GaragaKarthikeya/INSITU/experiments/results/kv_asymmetry_llama32.png

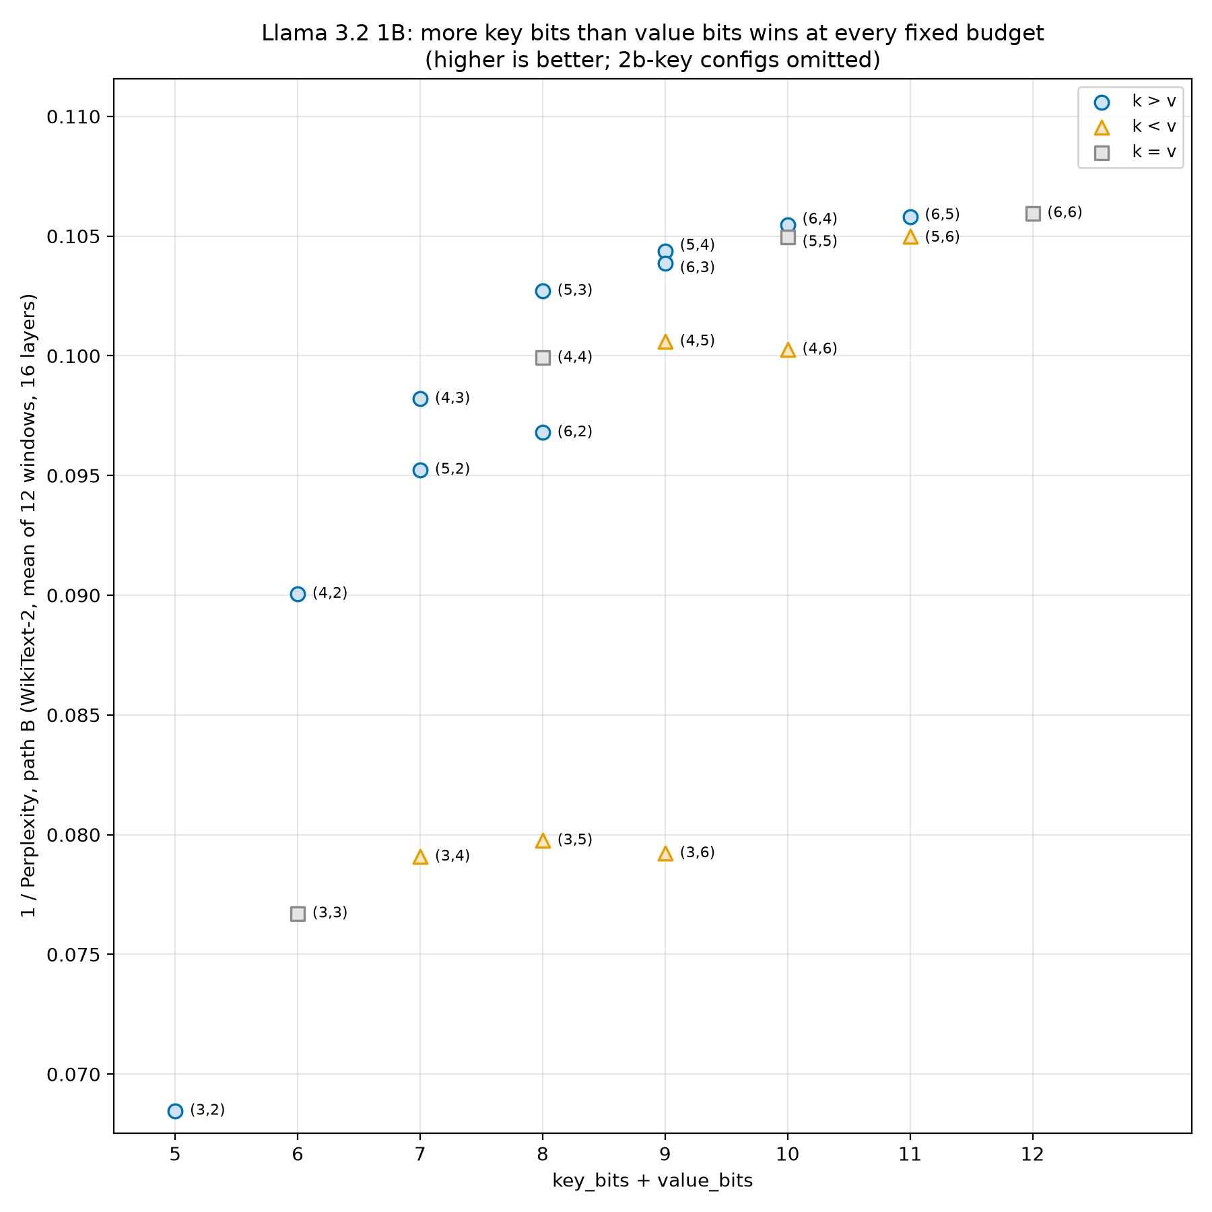
experiments/results/kv_asymmetry_llama32.png
