GaragaKarthikeya/INSITU/experiments/results/pareto_llama32_ppl_vs_bytes.png

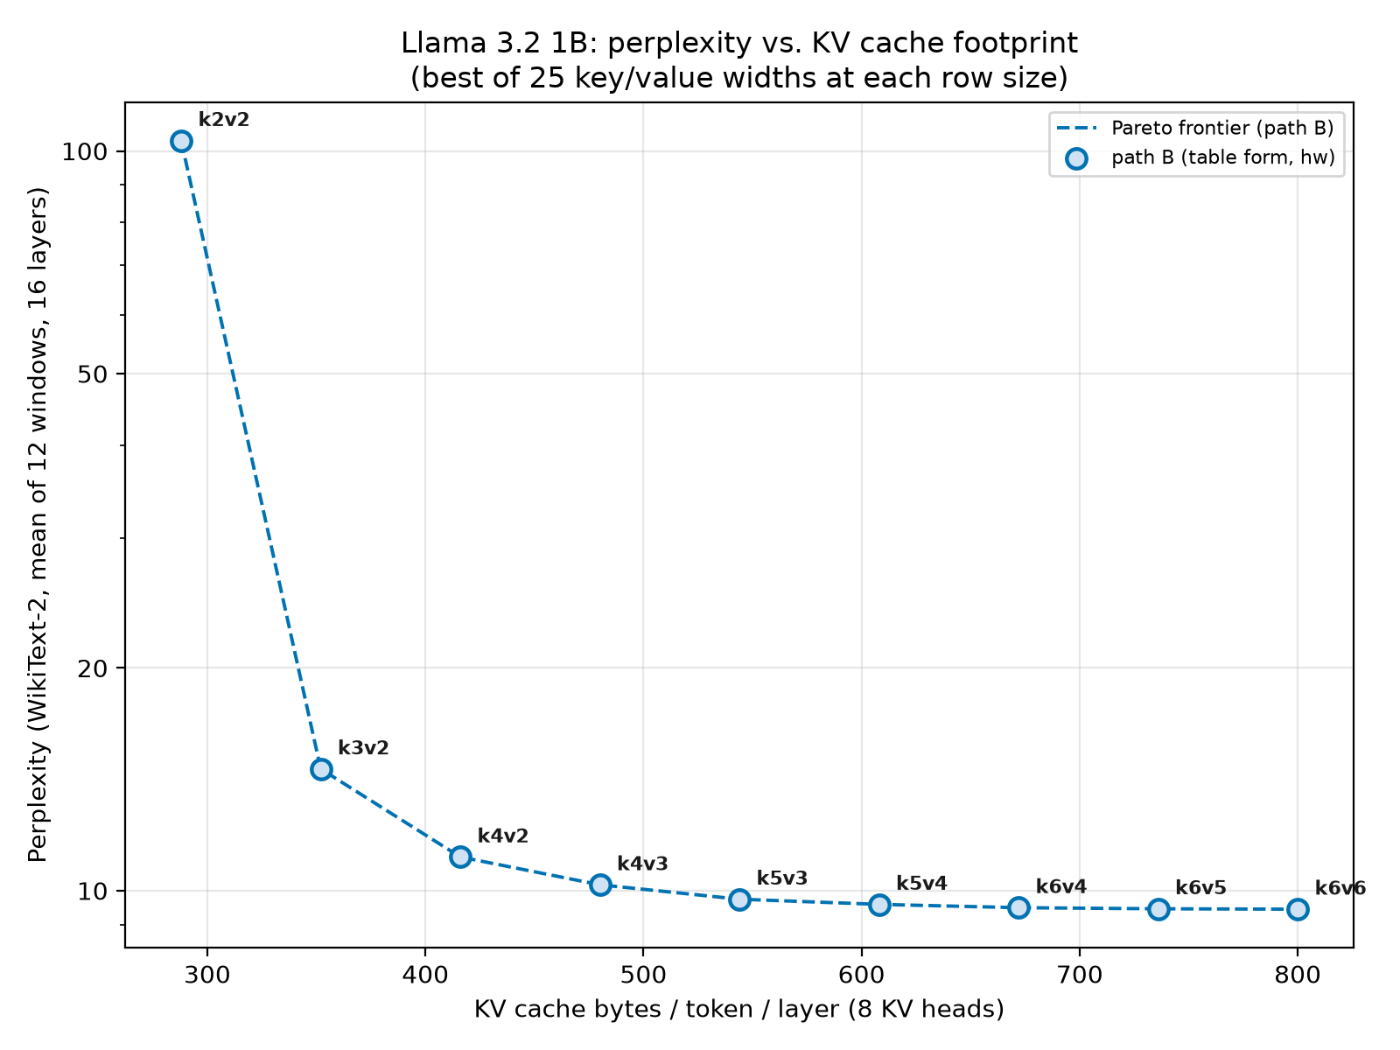
experiments/results/pareto_llama32_ppl_vs_bytes.png
