GaragaKarthikeya/INSITU/sw/attn_eth.c

/*
 * Raw Ethernet server on the A53. No IP, no lwIP, no OS. Step 14's transport.
 *
 * Why raw frames and not a socket stack
 * -------------------------------------
 * `plan.MD` budgets 35 us of round trip and 123 us of wire time for a 15 KB
 * token at ctx 32k, against 927 us of DDR -- so the network is a minor term
 * and the only thing that would make it a major one is a stack. lwIP on a
 * baremetal A53 costs more in copies and timers than the wire costs in
 * nanoseconds. A frame with a custom ethertype needs neither.
 *
 * The link is a metre of cable between two devices with nothing else on it, so
 * there is no retransmit and no congestion control. A dropped frame is a bug
 * to find, not a condition to recover from -- and the host's sequence number
 * is what turns "we lost one" into an error rather than into a wrong answer.
 *
 * Fragmentation, because 9,216 bytes does not fit in a frame
 * ----------------------------------------------------------
 * A request is the header plus up to 9,216 bytes of token, and an untagged
 * frame carries 1,500. So a request arrives as a run of frames each carrying
 * `{seq, frag, nfrag}` and its slice of the byte stream, and the server
 * reassembles by offset rather than by arrival order. `host/attn_client.py`'s
 * `RawEthClient` is the other half and the two share `attn_proto.h`.
 *
 * The payload is never touched
 * ----------------------------
 * Fragments are reassembled straight into the DMA's transmit buffer, so the
 * bytes that came off the wire are the bytes the core consumes. That is the
 * rule `attn_proto.h` is built around: any repacking here is a memcpy of the
 * whole token on the critical path, and step 13 measured that at 366 us
 * against 67 us of block.
 */
#include <string.h>

#include "xemacps.h"
#include "xil_cache.h"
#include "xil_printf.h"
#include "xparameters.h"
#if __has_include("xtime_l.h")
#include "xtime_l.h"
#else
#include "xiltimer.h"
#include "xtimer_config.h"
#endif

#include "attn_eth.h"
#include "attn_proto.h"

/* GEM3 is the ZCU104's RJ45. Enabled in `create_bd_attn_dma.tcl`; the device
 * tree carried `status = "disabled"` before that and nothing here would have
 * worked. */
#define GEM_BASE        0xFF0E0000U

#define RXBD_COUNT      64
#define TXBD_COUNT      64
/* JUMBO. A reply is 6,188 bytes and a request 9,252; at a 1,500-byte MTU those
 * are five and seven frames. Five-frame replies are what kills this receiver --
 * 256 consecutive single-frame replies never did -- so the cheapest cure is to
 * stop sending five. At an MTU of 9,000 a reply is one frame and a request is
 * two. The GEM supports 10,240 (XEMACPS_RX_BUF_SIZE_JUMBO); the host side sets
 * its interface to match. */
#define FRAME_MAX       9728
#define BD_ALIGN        64

/* One DESCRIPTOR per cache LINE, and that IS the whole point.
 *
 * A descriptor is 16 bytes and a cache line is 64, so at the driver's natural
 * packing four descriptors share a line. Cache maintenance has no finer
 * granularity than a line, so flushing the one descriptor this side just
 * modified also writes back stale copies of its three neighbours -- erasing
 * whatever the GEM had written into them in the meantime.
 *
 * That is the bug behind every receive failure in this file. The whole-ring
 * flush destroyed all 64; the per-descriptor flush that replaced it still
 * destroyed 3 at a time, which is why reception survived sixteen single-frame
 * loads and died on the first request whose reply took five frames.
 *
 * `XEmacPs_BdRingCreate` spaces descriptors by whatever alignment it is given,
 * so asking for 64 puts each on its own line and makes a single-descriptor
 * flush mean exactly one descriptor. It costs 4 KB of BSS. */
#define BD_SEP          64

/* Our MAC. Locally administered (bit 1 of the first octet), so it cannot
 * collide with a real vendor's, and fixed so the host can address us without
 * discovery. */
static const u8 BOARD_MAC[6] = {0x02, 0x00, 0x5A, 0x77, 0xE0, 0x01};

static XEmacPs emac;

/* BD rings and buffers, uncached-by-flushing. The GEM masters DDR directly and
 * is not coherent with these caches, so every descriptor and buffer is flushed
 * before the hardware reads it and invalidated after the hardware writes it.
 * This is the same discipline the KV image needs, and the same bug if missed:
 * correct hardware, stale memory.
 *
 * `XEmacPs_BdRingMemCalc` sizes these rather than hand arithmetic. (An earlier
 * comment here claimed the hand-rolled size was four times too small and that
 * this was why the receiver was dead. It was not: the board reports
 * `rings 1024+256 B for 64+16 descriptors`, and the hand-rolled array was
 * 2,048 bytes -- larger than needed. The real fault was cache, below. The
 * driver's own macro is kept because it cannot be wrong, not because the old
 * one was.) */
/* `XEmacPs_BdRingMemCalc` sizes for the descriptors alone and not for the
 * separation the alignment forces: at BD_SEP = 64 it answered 1,024 bytes for
 * 64 descriptors that occupy 4,096. The ring then runs off the end of the
 * array. The bring-up line printing "1024 B for 64 descriptors at 64 B each"
 * is what caught it -- three numbers that cannot all be true. */
#define RXBD_BYTES  (RXBD_COUNT * BD_SEP)
#define TXBD_BYTES  (TXBD_COUNT * BD_SEP)

static u8 rx_bd_space[RXBD_BYTES] __attribute__((aligned(BD_ALIGN)));
static u8 tx_bd_space[TXBD_BYTES] __attribute__((aligned(BD_ALIGN)));

/* Parking descriptors for the priority queues this design does not use. */
static XEmacPs_Bd bd_rx_park __attribute__((aligned(BD_ALIGN)));
static XEmacPs_Bd bd_tx_park __attribute__((aligned(BD_ALIGN)));
static u8 rx_buf[RXBD_COUNT][FRAME_MAX] __attribute__((aligned(BD_ALIGN)));
static u8 tx_buf[FRAME_MAX] __attribute__((aligned(BD_ALIGN)));

static u8 host_mac[6];
static int host_known;

/* The DRIVER does NO cache MAINTENANCE ON DESCRIPTORS. `xemacps_bdring.c`
 * contains no `Xil_DCache*` call of any kind -- every flush and invalidate is
 * the caller's job. The A53 writes descriptors into cached DDR, the GEM reads
 * DDR without coherency, and so it sees whatever was in memory before the
 * cache lines were written back: zeros. It then owns no receive buffers and
 * accepts no frames, which is precisely the `rx 0 (0 ours)` this reported with
 * the PHY up and the link negotiated at 1 Gb/s.
 *
 * FLUSHING the whole RING IS wrong once the GEM IS RUNNING, and IT cost A
 * Whole DEBUG cycle. The GEM writes status bits into descriptors as frames
 * land. A flush of the entire ring writes this side's stale cached copies back
 * over those updates, erasing them -- the frames are received and then
 * un-received. The symptom was precise and misleading: the first request
 * assembled perfectly (7/7 fragments, every header field correct, the step ran
 * and replied in 22 us) and then reception stopped dead, because the flush
 * after the first frame clobbered the descriptors the GEM had already filled
 * for the rest.
 *
 * So a flush covers exactly the one descriptor this side modified. Whole-ring
 * INVALIDATE stays: it discards clean lines and can only lose data this side
 * has written and not flushed, which by construction never happens.
 * Whole-ring flush is kept only for setup, before the GEM is started. */
/* Exactly one descriptor, which is exactly one cache line -- see BD_SEP. */
static void bd_flush_one(void *bd) { Xil_DCacheFlushRange((UINTPTR)bd, BD_SEP); }
static void bd_inval_rx(void)  { Xil_DCacheInvalidateRange((UINTPTR)rx_bd_space, RXBD_BYTES); }
static void bd_inval_tx(void)  { Xil_DCacheInvalidateRange((UINTPTR)tx_bd_space, TXBD_BYTES); }
static void bd_flush_all(void) {
    Xil_DCacheFlushRange((UINTPTR)rx_bd_space, RXBD_BYTES);
    Xil_DCacheFlushRange((UINTPTR)tx_bd_space, TXBD_BYTES);
}

/* Counted and printed, because a silent receiver and a receiver that drops
 * everything look identical from the far end. `rx_any` is every frame the MAC
 * accepted; `rx_ours` is those with our ethertype. If the first is climbing
 * and the second is not, the filter or the ethertype is wrong -- which is a
 * different bug from a dead link, and the UART should say which. */
static u32 rx_any, rx_ours, tx_frames, rx_stalls, tx_errs;

/* --------------------------------------------------------------------------
 * PHY
 *
 * The address is SCANNED, not assumed. Boards move the DP83867 between MDIO
 * addresses and a wrong constant looks exactly like a dead link -- which is
 * the least diagnosable failure in this whole file.
 * -------------------------------------------------------------------------- */
static int phy_find(XEmacPs *e)
{
    for (u32 a = 0; a < 32; a++) {
        u16 id1 = 0, id2 = 0;
        XEmacPs_PhyRead(e, a, 2, &id1);
        XEmacPs_PhyRead(e, a, 3, &id2);
        if (id1 != 0xFFFF && id1 != 0x0000) {
            xil_printf("ETH: PHY at MDIO %u (id %04x:%04x)\r\n",
                       (unsigned)a, id1, id2);
            return (int)a;
        }
    }
    return -1;
}

static int phy_wait_link(XEmacPs *e, u32 phy, u32 timeout_ms)
{
    /* Status register bit 2 is link, and it is LATCHING low: it must be read
     * twice to clear a stale down-event, or a link that came up before this
     * ran reports itself as down forever. */
    for (u32 i = 0; i < timeout_ms; i++) {
        u16 st = 0;
        XEmacPs_PhyRead(e, phy, 1, &st);
        XEmacPs_PhyRead(e, phy, 1, &st);
        if (st & 0x0004U)
            return 1;
        for (volatile int d = 0; d < 100000; d++) { }
    }
    return 0;
}

/* Link speed from the DP83867's status register 0x11, which is where it
 * reports the NEGOTIATED rate. Reading the control register instead gives what
 * was ADVERTISED, which is not the same thing on a link that fell back. */
static u32 phy_speed(XEmacPs *e, u32 phy)
{
    u16 s = 0;
    XEmacPs_PhyRead(e, phy, 0x11, &s);
    switch ((s >> 14) & 0x3U) {
    case 0: return 10;
    case 1: return 100;
    case 2: return 1000;
    default: return 0;
    }
}

/* --------------------------------------------------------------------------
 * bring-up
 * -------------------------------------------------------------------------- */
int attn_eth_init(void)
{
    XEmacPs_Config *cfg = XEmacPs_LookupConfig(GEM_BASE);
    if (!cfg) {
        xil_printf("ETH: no GEM config at %08x -- is ENET3 enabled in the BD?\r\n",
                   (unsigned)GEM_BASE);
        return -1;
    }
    if (XEmacPs_CfgInitialize(&emac, cfg, cfg->BaseAddress) != XST_SUCCESS) {
        xil_printf("ETH: CfgInitialize failed\r\n");
        return -1;
    }
    /* Before anything else: the option changes the DMA receive buffer size the
     * driver programs, so it has to be set before the rings are built. */
    if (XEmacPs_SetOptions(&emac, XEMACPS_JUMBO_ENABLE_OPTION) != XST_SUCCESS) {
        xil_printf("ETH: the controller refused jumbo frames\r\n");
        return -1;
    }
    XEmacPs_SetMacAddress(&emac, (void *)BOARD_MAC, 1);

    int phy = phy_find(&emac);
    if (phy < 0) {
        xil_printf("ETH: no PHY answered on MDIO 0..31\r\n");
        return -1;
    }
    if (!phy_wait_link(&emac, (u32)phy, 5000)) {
        xil_printf("ETH: no link. Is the cable in?\r\n");
        return -1;
    }
    u32 mbps = phy_speed(&emac, (u32)phy);
    xil_printf("ETH: link up at %u Mb/s\r\n", (unsigned)mbps);
    if (mbps == 0)
        return -1;
    XEmacPs_SetOperatingSpeed(&emac, (u16)mbps);
    /* `XEmacPs_SetOperatingSpeed` writes the MAC's NWCFG register only -- it
     * does not touch the CRL_APB TX clock divisor. That is `psu_init`'s job,
     * which does it now that ENET3 is enabled in the block design. */
    XEmacPs_SetMdioDivisor(&emac, MDC_DIV_224);

    /* -- BD rings ------------------------------------------------------- */
    XEmacPs_BdRing *rxr = &XEmacPs_GetRxRing(&emac);
    XEmacPs_BdRing *txr = &XEmacPs_GetTxRing(&emac);
    XEmacPs_Bd tmpl;

    XEmacPs_BdClear(&tmpl);
    if (XEmacPs_BdRingCreate(rxr, (UINTPTR)rx_bd_space, (UINTPTR)rx_bd_space,
                             BD_SEP, RXBD_COUNT) != XST_SUCCESS ||
        XEmacPs_BdRingClone(rxr, &tmpl, XEMACPS_RECV) != XST_SUCCESS) {
        xil_printf("ETH: rx ring setup failed\r\n");
        return -1;
    }
    XEmacPs_BdClear(&tmpl);
    XEmacPs_BdSetStatus(&tmpl, XEMACPS_TXBUF_USED_MASK);
    if (XEmacPs_BdRingCreate(txr, (UINTPTR)tx_bd_space, (UINTPTR)tx_bd_space,
                             BD_SEP, TXBD_COUNT) != XST_SUCCESS ||
        XEmacPs_BdRingClone(txr, &tmpl, XEMACPS_SEND) != XST_SUCCESS) {
        xil_printf("ETH: tx ring setup failed\r\n");
        return -1;
    }

    bd_flush_all();

    /* Hand every receive buffer to the hardware. */
    for (int i = 0; i < RXBD_COUNT; i++) {
        XEmacPs_Bd *bd;
        if (XEmacPs_BdRingAlloc(rxr, 1, &bd) != XST_SUCCESS) return -1;
        XEmacPs_BdSetAddressRx(bd, (UINTPTR)rx_buf[i]);
        XEmacPs_BdClearRxNew(bd);
        Xil_DCacheInvalidateRange((UINTPTR)rx_buf[i], FRAME_MAX);
        if (XEmacPs_BdRingToHw(rxr, 1, bd) != XST_SUCCESS) return -1;
    }
    /* The descriptors the GEM is about to fetch. Without this it fetches the
     * pre-`ToHw` contents and owns nothing. Safe as a whole-ring flush because
     * the GEM has not been started yet and owns none of them. */
    bd_flush_all();

    /* TIE OFF the QUEUES this DESIGN does not USE.
     *
     * The ZynqMP GEM supports priority queuing, and the driver's own examples
     * park every queue but the one in use -- "for avoiding the controller to
     * malfunction by fetching the descriptors from these queues". Leaving them
     * unset is not a performance question: the controller reads whatever the
     * pointers happen to contain and the receiver stops working. That is what
     * `rx 0 (0 ours)` on the UART looked like, with the PHY up and the link
     * negotiated at 1 Gb/s. */
    if (emac.MaxQueues > 1) {
        XEmacPs_BdClear(&bd_rx_park);
        XEmacPs_BdSetAddressRx(&bd_rx_park,
                               (XEMACPS_RXBUF_NEW_MASK | XEMACPS_RXBUF_WRAP_MASK));
        XEmacPs_BdClear(&bd_tx_park);
        XEmacPs_BdSetStatus(&bd_tx_park,
                            (XEMACPS_TXBUF_USED_MASK | XEMACPS_TXBUF_WRAP_MASK));
        Xil_DCacheFlushRange((UINTPTR)&bd_rx_park, 64);
        Xil_DCacheFlushRange((UINTPTR)&bd_tx_park, 64);
        for (u8 q = 0; q < emac.MaxQueues; q++) {
            if (q == 0) continue;
            XEmacPs_SetQueuePtr(&emac, (UINTPTR)&bd_rx_park, q, XEMACPS_RECV);
            XEmacPs_SetQueuePtr(&emac, (UINTPTR)&bd_tx_park, q, XEMACPS_SEND);
        }
        xil_printf("ETH: parked %u unused queues\r\n",
                   (unsigned)(emac.MaxQueues - 1));
    }

    XEmacPs_SetQueuePtr(&emac, emac.RxBdRing.BaseBdAddr, 0, XEMACPS_RECV);
    XEmacPs_SetQueuePtr(&emac, emac.TxBdRing.BaseBdAddr, 0, XEMACPS_SEND);

    /* The screening register the example sets alongside the queue pointers:
     * it is what routes matching frames to queue 0. */
    XEmacPs_WriteReg(emac.Config.BaseAddress, XEMACPS_SCREEN_TYPE2_REG0,
                     XEMACPS_CMPA_ENABLE_MASK | 0U);

    XEmacPs_Start(&emac);

    xil_printf("ETH: rings %u+%u B for %u+%u descriptors at %u B each "
               "(bd %u B), %u queues\r\n",
               (unsigned)RXBD_BYTES, (unsigned)TXBD_BYTES,
               (unsigned)RXBD_COUNT, (unsigned)TXBD_COUNT, (unsigned)BD_SEP,
               (unsigned)sizeof(XEmacPs_Bd), (unsigned)emac.MaxQueues);
    xil_printf("ETH: jumbo on, frame buffer %u B, reply fits in one frame\r\n",
               (unsigned)FRAME_MAX);
    xil_printf("ETH: ready, MAC %02x:%02x:%02x:%02x:%02x:%02x, ethertype %04x\r\n",
               BOARD_MAC[0], BOARD_MAC[1], BOARD_MAC[2],
               BOARD_MAC[3], BOARD_MAC[4], BOARD_MAC[5],
               (unsigned)ATTN_ETHERTYPE);
    return 0;
}

/* --------------------------------------------------------------------------
 * one frame in, one frame out
 * -------------------------------------------------------------------------- */
int attn_eth_recv(u8 *dst, int max)
{
    XEmacPs_BdRing *rxr = &XEmacPs_GetRxRing(&emac);
    XEmacPs_Bd *bd;

    /* CLEAR the receive STATUS, OR the GEM STOPS for good.
     *
     * `XEMACPS_RXSR_BUFFNA_MASK` latches the instant the controller finds no
     * free descriptor -- even for one frame, even momentarily -- and while it
     * is set the receiver stays off no matter how many descriptors are handed
     * back afterwards. It is write-one-to-clear, and the only code in the
     * driver that clears it lives in `xemacps_intr.c`. This server is polled
     * and installs no handler, so nothing cleared it.
     *
     * That is why reception ran perfectly for 1,600 frames -- 256 cache-zeroing
     * loads and nine decode steps, counters advancing +7 and +5 exactly on
     * schedule -- and then stopped dead. Overrun and a bad AHB response latch
     * the same way and are cleared here too. */
    {
        u32 sr = XEmacPs_ReadReg(emac.Config.BaseAddress, XEMACPS_RXSR_OFFSET);
        if ((sr & XEMACPS_RXSR_ERROR_MASK) != 0U) {
            XEmacPs_WriteReg(emac.Config.BaseAddress, XEMACPS_RXSR_OFFSET, sr);
            if (++rx_stalls <= 4U)
                xil_printf("ETH: rx status %08x cleared (#%u) after %u frames\r\n",
                           (unsigned)sr, (unsigned)rx_stalls, (unsigned)rx_any);
        }
    }

    /* The GEM marks a descriptor used by writing DDR; this side must not read
     * that through a stale cache line. */
    bd_inval_rx();
    if (XEmacPs_BdRingFromHwRx(rxr, 1, &bd) == 0)
        return 0;

    u32 len = XEmacPs_BdGetLength(bd);
    UINTPTR addr = XEmacPs_BdGetBufAddr(bd);
    Xil_DCacheInvalidateRange(addr, len);

    int taken = 0;
    const u8 *f = (const u8 *)addr;
    rx_any++;
    if (rx_any <= 4)
        xil_printf("ETH: rx #%u len %u type %04x from "
                   "%02x:%02x:%02x:%02x:%02x:%02x\r\n",
                   (unsigned)rx_any, (unsigned)len,
                   (unsigned)((f[12] << 8) | f[13]),
                   f[6], f[7], f[8], f[9], f[10], f[11]);
    /* 12 bytes of MAC, 2 of ethertype. Anything else on the wire -- and on a
     * direct cable there should be nothing -- is dropped here. */
    if (len > 14 && ((f[12] << 8) | f[13]) == ATTN_ETHERTYPE) {
        rx_ours++;
        if (!host_known) {
            memcpy(host_mac, f + 6, 6);      /* reply to whoever asked */
            host_known = 1;
            xil_printf("ETH: host is %02x:%02x:%02x:%02x:%02x:%02x\r\n",
                       f[6], f[7], f[8], f[9], f[10], f[11]);
        }
        taken = (int)len - 14;
        if (taken > max) taken = max;
        memcpy(dst, f + 14, (size_t)taken);
    }

    /* Give the buffer straight back, whether it was ours or not: a ring that
     * leaks descriptors stops receiving after RXBD_COUNT frames, which looks
     * like the host going quiet. */
    XEmacPs_BdRingFree(rxr, 1, bd);
    if (XEmacPs_BdRingAlloc(rxr, 1, &bd) == XST_SUCCESS) {
        XEmacPs_BdSetAddressRx(bd, addr);
        /* CLEARING "new" IS the CALLER'S JOB, and FORGETTING IT IS AN INFINITE
         * LOOP RATHER THAN A DROPPED FRAME.
         *
         * Bit 0 of an RX descriptor's address word means "the GEM has filled
         * this buffer". The CPU clears it to hand ownership back.
         * `XEmacPs_BdSetAddressRx` deliberately PRESERVES the low bits (it
         * masks the address in), and `XEmacPs_BdRingToHw` never touches them
         * -- `RXBUF_NEW_MASK` does not appear in any of the driver's .c files.
         *
         * Left set, the GEM will not reuse the buffer, `BdRingFromHwRx`
         * reports it complete again on the very next call, and the same frame
         * is delivered forever. The board served the same request 948,353
         * times and saturated the link at 300 Mb/s; from the host it looked
         * like a hang eight layers in. */
        XEmacPs_BdClearRxNew(bd);
        Xil_DCacheInvalidateRange(addr, FRAME_MAX);
        XEmacPs_BdRingToHw(rxr, 1, bd);
        bd_flush_one(bd);          /* THIS descriptor only -- see above */
    } else {
        /* Silently losing a descriptor drains the ring one frame at a time and
         * ends in a receiver that has simply stopped. */
        xil_printf("ETH: rx ring exhausted -- a descriptor leaked\r\n");
    }
    return taken;
}

int attn_eth_send(const u8 *payload, int len)
{
    if (!host_known || len > FRAME_MAX - 14)
        return -1;

    XEmacPs_BdRing *txr = &XEmacPs_GetTxRing(&emac);
    XEmacPs_Bd *bd;

    memcpy(tx_buf, host_mac, 6);
    memcpy(tx_buf + 6, BOARD_MAC, 6);
    tx_buf[12] = (u8)(ATTN_ETHERTYPE >> 8);
    tx_buf[13] = (u8)(ATTN_ETHERTYPE & 0xFF);
    memcpy(tx_buf + 14, payload, (size_t)len);

    int total = len + 14;
    /* The minimum Ethernet frame is 60 bytes before the FCS. Short frames are
     * padded by the MAC on this part, but the padding is not zeroed -- so it
     * is zeroed here rather than sending whatever was in the buffer. */
    if (total < 60) {
        memset(tx_buf + total, 0, (size_t)(60 - total));
        total = 60;
    }
    Xil_DCacheFlushRange((UINTPTR)tx_buf, (u32)total);

    if (XEmacPs_BdRingAlloc(txr, 1, &bd) != XST_SUCCESS)
        return -1;
    XEmacPs_BdSetAddressTx(bd, (UINTPTR)tx_buf);
    XEmacPs_BdSetLength(bd, (u32)total);
    XEmacPs_BdClearTxUsed(bd);
    XEmacPs_BdSetLast(bd);
    if (XEmacPs_BdRingToHw(txr, 1, bd) != XST_SUCCESS) {
        /* Returning without freeing leaks a descriptor, and sixteen leaks is a
         * transmitter that has silently stopped. Every exit below frees. */
        XEmacPs_BdRingUnAlloc(txr, 1, bd);
        xil_printf("ETH: ToHw refused a tx descriptor\r\n");
        return -1;
    }
    bd_flush_one(bd);
    XEmacPs_Transmit(&emac);

    /* Polled: wait for the descriptor to come back before reusing `tx_buf`. */
    /* Polled completion. The guard is small enough that a stuck transmitter is
     * reported in milliseconds rather than looking like a hang, and the
     * descriptor is freed either way. */
    u32 guard = 2000000;
    while (guard) {
        bd_inval_tx();
        if (XEmacPs_BdRingFromHwTx(txr, 1, &bd) != 0) break;
        guard--;
    }
    if (!guard) {
        xil_printf("ETH: tx did not complete (%u frames sent so far)\r\n",
                   (unsigned)tx_frames);
        return -1;
    }
    XEmacPs_BdRingFree(txr, 1, bd);
    tx_frames++;
    /* The transmit side latches the same way: a used-bit-read or an underrun
     * stops it until acknowledged. */
    {
        u32 sr = XEmacPs_ReadReg(emac.Config.BaseAddress, XEMACPS_TXSR_OFFSET);
        if ((sr & XEMACPS_TXSR_ERROR_MASK) != 0U) {
            XEmacPs_WriteReg(emac.Config.BaseAddress, XEMACPS_TXSR_OFFSET, sr);
            if (++tx_errs <= 4U)
                xil_printf("ETH: tx status %08x cleared (#%u)\r\n",
                           (unsigned)sr, (unsigned)tx_errs);
        }
    }
    return len;
}

void attn_eth_forget_host(void)
{
    host_known = 0;
}

void attn_eth_stats(u32 *any, u32 *ours, u32 *tx)
{
    if (any)  *any  = rx_any;
    if (ours) *ours = rx_ours;
    if (tx)   *tx   = tx_frames;
}

u32 attn_eth_stalls(void) { return rx_stalls; }
