GaragaKarthikeya/INSITU/(commit log)

2026-09-03 Add unit tests for numerics, quantization, rotation, and tracing
    - Introduced `test_numerics.py` to validate fixed-point and floating-point operations, including Hadamard transforms, rounding modes, and quantization behavior.
    - Created `test_quantize.py` to ensure lossless encoding/decoding, validate distortion bounds, and check quantizer behavior with various configurations.
    - Added `test_rotation.py` to verify orthonormality, inner product preservation, and the effects of different seeds on rotation transformations.
    - Implemented `trace.py` to log operations performed during computations, capturing details about memory usage and operation counts.
    - Introduced `weights.py` to manage weights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
2026-09-03 Model Llama 3's RoPE frequency scaling
    `ModelConfig.from_hf` refused any rope_type but "default", so Llama-3.2-1B
    could not be grafted at all: it sets rope_type "llama3", a wavelength-piecewise
    rescaling of inv_freq. Refusing was right -- serving a scaled model on the
    default table misplaces tokens and produces fluent nonsense -- but it left the
    kernel unable to run on the model.
    `RopeScaling` implements the three regimes: short wavelengths untouched, long
    divided by `factor`, the band between them linearly interpolated. It is applied
    once when the sin/cos table is built, so it changes the table and nothing else
    -- the apply path, the trace it emits and the cycles hw/ replays are identical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
    [run.py, test_rope_scaling.py]
2026-09-04 Plan the host/PL split and model the PL side in Python
    Steps 1-4 of plan.MD, the Python half. The seam is placed after RoPE and
    before W_o', on a value kernel.py already computes, so no numeric path
    changes: 124 checks and the cosine 1.000000 control stay green.
    - config.py: RotateConfig, EncoderConfig, AttentionConfig, CacheConfig and
    HardwareConfig.zcu104(), pinning 250 MHz and a 4x128 b interface.
    - hw/attn_block.py: RotateUnit, EncoderUnit, AttentionUnit, CacheBandwidth.
    replay resolves every unit by getattr; a unit that costs the PL nothing
    must be declared in HOST_UNITS with its reason. SCORE and ACCUMULATE are
    the max, not the sum, and the cache reports both of its bounds.
    -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
    [run.py, test_hardware.py]
2026-09-04 Measure ZCU104 DDR bandwidth before sizing anything against it
    Step 1. The whole design was sized from an assumed ~13.4 GB/s, so measure
    it first: 4 AXI-HP masters over a multi-MB region, swept at runtime from one
    bitstream across ports x burst x outstanding. Closed at 250 MHz, two runs
    across a power cycle, run 2 taking the median of five repeats.
    14,708 MB/s at 4 ports, burst 64, outstanding 2 -- 77% of the DDR4-2400
    peak, against the engine's 13.0 GB/s appetite. The gate passes with 13%
    headroom; PARALLEL_KV=1 needs no clock or format change.
    The prefetcher must be shallow. Depth 2 beats depth 4+ by 19%, and the
    deeper queues are also 3-6% noisy against 0.25% at depth 2 -- four streams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
2026-09-04 Implement the forward randomized FWHT rotation in RTL
    Step 5. rot_fwht.sv: six levels of 32 add/sub butterflies, the seed-0 sign
    diagonal as a SIGN_NEG parameter, exact >>> 3. The non-exact branch is a
    compile-time absence -- SHIFT is hard-coded for d = 64, and any other
    dimension belongs on ops/rotate.py's reciprocal-multiply path.
    Sign extension happens before the diagonal negation, because -24'sh800000
    is +2^23 and does not fit the input width. range_error reports a normalized
    result too wide for 24 bits rather than wrapping behind the numeric model.
    tb_rot checks 1,072 vectors -- the 48 real q/k/v tensors tapped from the
    unmodified kernel plus 1,024 random -- and asserts the DUT sign w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
    [rot_fwht.sv, tb_rot.sv]
2026-09-04 Encode a rotated vector to codes and a norm, in RTL
    Step 6. rot_norm.sv is the only producer of the norm: RMS at wire precision,
    rounded half-to-even, so the encoder thresholds against the same integer the
    cache row carries. Thresholding against a wider norm would put encoder and
    decoder on different numbers and decode near-boundary channels into the wrong
    bin -- a fraction of a percent, invisible to every test not looking for it.
    rot_encode.sv scales the boundaries by that norm once per vector, so there is
    no divider and every channel is a comparison.
    Both blocks fold 8 of 64 channels per cycle. Phase A runs once per token
    against a Phase B that runs once per CACHED token, so 64 squarers a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
    [rot_encode.sv, rot_norm.sv, tb_rot_encode.sv, tb_rot_norm.sv, test_hardware.py]
2026-09-04 Score a cached row against a precomputed product table, in RTL
    Step 7. `qtab_build.sv` builds the 64 x 16 table of q_rot[ch] * centroid[i]
    once per query vector; `score_lane.sv` gathers it at a row's key codes, reduces
    in six levels, multiplies by the row's norm and shifts. Two DSPs in the inner
    loop where a dense unit needs sixty-four.
    2,080 scores bit-exact against CompressedAttention.scores -- all 32 query heads
    against the 65 cached tokens those scores were computed over -- plus 32,768
    table entries swept exhaustively and 239 stalled cycles of back-pressure. The
    lane splits the raw 52-byte row itself, so _pack_codes's layout is under test
    rather than mirrored.
    Two corrections that meas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
    [qtab_build.sv, score_lane.sv, tb_qtab_build.sv, tb_score_lane.sv, test_vectors.py]
2026-09-04 Run the online softmax and the value accumulator in RTL
    Step 8. `exp_lut.sv` is exp(-x) as a 256-entry fraction table and a shift;
    `softmax_online.sv` carries the running maximum and sum, speculating "no new
    max" and stalling to rescale on the rare path; `accum.sv` folds the value plane
    into 64 channels through four multipliers and a mux.
    Bit-exact against `attend_online` -- not `attend_two_pass` -- on every token:
    m, l, the probability, the rescale factor and all 64 accumulator channels, over
    two stimulus sets x 4 lanes x 65 tokens, plus 13,565 exp deltas.
    `CompressedAttention.on_step` is a new read-only observer, same `is not None`
    contract as `AttentionKernel.on_stage`, so the goldens co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
    [accum.sv, exp_lut.sv, softmax_online.sv, tb_exp_lut.sv, tb_softmax_accum.sv, test_vectors.py]
2026-09-04 Divide by the softmax denominator, in RTL
    Step 9, which closes Phase 2. `finalize.sv` inverts `l` once per query head --
    32 cycles of restoring division -- and multiplies the 64 accumulator channels
    by it, four per cycle. Its output is the seam: `merge_heads(out)` in Q16,
    exactly what the FPGA returns to the host.
    44 rows bit-exact against `reciprocal` and `_finalize`. Thirty-two are the
    accumulator and denominator each head's scan really ended on, now tapped for
    every head rather than group 0 alone; a Python check asserts the kernel's own
    two lines on those reproduce out.online.hex.
    The other twelve are constructed, and they are the point. Every head ends the
    same length of scan, so every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
    [finalize.sv, tb_finalize.sv, test_vectors.py]
2026-09-05 Run the whole attention block, from the wire to the answer
    `attn_top.sv` is the control that makes ten verified blocks one datapath, and
    the only thing it can get wrong is order: which vector is a key, when a product
    table may be swapped, and whether the token being scored is already in the
    cache. So the FSM is one sequence per group and the interesting order is a
    state name rather than a counter comparison.
    `tb_attn` hands it `ingress.hex` -- 144 beats, 8 groups of 6 vectors -- and
    checks the 32 heads it returns against `out.online.hex`, bit for bit. Nothing
    in between is given to the hardware. 4,170 cycles for 520 rows at ctx 64.
    Token 64 is blanked in the DDR image, because the kernel h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
    [accum.sv, attn_ingress.sv, attn_top.sv, finalize.sv, kv_write.sv, rot_norm.sv, tb_attn.sv]
2026-09-05 Run one decode step on the ZCU104, bit-exact, over JTAG
    The block ran on real silicon and returned all 2,048 channels bit-exact
    against `out.online.hex` -- the numpy kernel's own answer for the same step.
    Token 64's cache row reached DDR only through the block's own AXI write
    master: the image is loaded with that row zeroed, so a design that never wrote
    it would have scored a blank key against itself.
    The clock is 150 MHz, and that is a real result rather than a rounding. The
    full system missed 250 MHz by -1.953 ns across 49,557 endpoints, against
    +0.053 ns for `attn_top` out of context. Step 12 claims correctness and not a
    rate, but a bitstream that misses timing is worse than useless FOR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
    [attn_ctrl.sv, attn_top.sv, tb_attn_ctrl.sv]
2026-09-05 Close 250 MHz in the full system, and run it on the board
    The block runs at its design clock on the ZCU104 and returns all 2,048
    channels bit-exact against out.online.hex. Full system: WNS +0.006 ns, hold
    +0.010 ns, from -1.953 ns with 49,557 failing endpoints.
    Out of context was the misleading measurement. The core sat at +0.008 ns with
    a whole die to spread across, and every path that killed the system was one
    the placer could hide there. Seven fixes, each read off the routed report
    rather than guessed:
    - the FSM state decoded into 6,144 `egr` flop enables, and again into 6,144
    `q_vec` enables -- the same bug twice, invisible out of context
    - `grp * head_stride` at 49 bits, when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
    [accum.sv, attn_top.sv, softmax_online.sv]
2026-09-05 Count the step's own cycles, and make the plane map addressable
    Step 13 needs a device-side time, and the A53 cannot supply one: it reads a
    wall clock over a bus it shares with the block, so it can time a decode step
    but not the scan inside one. `attn_top` now counts both itself --
    `scan_cycles` over S_SCAN and `busy_cycles` from start to done -- and the shim
    exposes them at 0x30 and 0x34. The DDR bandwidth claim is 8 x n_tokens x
    row_bytes over `scan_cycles`, and every term in it comes from the clock the
    reads were issued on.
    `tb_attn` checks `busy_cycles` against the BENCH's own clock, not against
    itself: a counter that only agrees with the design it lives in would report a
    confident numb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
    [attn_ctrl.sv, attn_top.sv, tb_attn.sv, tb_attn_ctrl.sv, test_ddr_layout.py]
2026-09-05 Hand the block to the A53: vectors, software, and a PS-mastered system
    Step 13's pieces, before the board sees them.
    `hw/board_vectors.py` emits what step 12 could not test. Each case loads a
    cache image holding tokens 0..ctx0-1 and NOTHING else, then runs four decode
    steps on it: token ctx0+n scores against n rows that exist only because the
    block's own AXI write master put them in DDR and the next scan's address
    generator found them again. A write path off by one plane or one token answers
    step 0 correctly and every step after it wrongly, which is invisible to a
    one-step bench and to a one-step JTAG run. Three contexts -- 64, 256, 1,024 --
    so the strides and spans the host programs are th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
    [attn_main.c, run.py, test_board_vectors.py]
2026-09-05 Run twelve decode steps on the A53, at three contexts, bit-exact
    Step 13. No JTAG in the loop: the cable programs the PL and downloads the ELF
    and then gets out of the way, and every AXI transaction of the run is issued by
    the A53.
    Twelve steps across contexts 64, 256 and 1,024 -- 18,432 channels, all exact
    against the numpy kernel. No clips, no accumulator overflow, no channel outside
    the 24-bit seam.
    The multi-step run is what earns its keep. Each case loads an image holding
    tokens 0..ctx0-1 and nothing else, so token ctx0+n scores against n rows that
    exist only because the block's own write master put them in DDR and the NEXT
    scan's address generator found them again. A write off by one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
    [attn_main.c]
2026-09-05 Record a precision ceiling the test suite is structurally blind to
    `finalize` computes recip = floor(2**31 / l) in Q16, and the online denominator
    measures l = T * 2**15 to within 0.2% across six contexts -- near-uniform
    attention makes every p near unity. So recip = 2**16 / T, and the final
    divide's precision falls linearly in context: 64 levels at ctx 1,024, 8 at
    8,192, 2 at 32,768, 1 at 65,536, and 0 at 131,072, where l_too_big fires and
    every output channel is zero.
    The error is the fractional part of 2**31/l, which makes it a lottery. At
    powers of two l lands just above an integer and the error is 0.2%; at ctx
    24,576 it is 25.2%. Every context this project has ever tested -- 32, 64, 25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
2026-09-05 Normalise the final divide, so precision stops tracking the context
    The defect recorded as limit 9, fixed in both halves at once.
    `reciprocal` was `floor(2**31 / l)` at a fixed Q16. The online denominator is
    l = T * 2**15, so the quotient was 2**16 / T: 64 levels at ctx 1,024, 8 at
    8,192, 2 at 32,768, 1 at 65,536 and 0 at 131,072, where every output channel
    went to zero. The error was the fractional part of 2**31/l, which made it a
    lottery -- 0.2% at powers of two, 25.2% at ctx 24,576 -- and every context this
    project had tested is a power of two.
    Now `l` is shifted into the divisor's 32-bit window, left when it is small and
    right when it is large, and the numerator is the constant 2**62.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
    [finalize.sv, tb_finalize.sv, test_attention.py, test_vectors.py]
2026-09-05 Take the priority encoder out of the divide loop
    Normalising the divide cost `finalize` its timing: +0.863 ns to -0.028. A
    register on the output shift recovered +0.022, which left it the critical path
    and thin enough that `attn_top`, which closed at +0.082 in the full system,
    would very likely have gone negative on it.
    The first guess was the output barrel shifter -- a 65-bit variable arithmetic
    shift over a range of 47 is a six-level mux, and it is the obvious suspect.
    Splitting it by eights and then by the remainder bought **0.002 ns**.
    The routed report named something else: `l_h` through the priority encoder and
    the normaliser and then in series with the remainder's compare-and-subtra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
2026-09-05 Give the shim a DMA stream, and gate it on busy
    Step 13 measured 366 us of every 433 us decode step as the A53 walking 15 KB
    through the 32-bit AXI-Lite window one store at a time -- 85% of the step,
    against 67 us of block. This is the path that replaces it: a 512-bit AXI4-Stream
    slave and master on `attn_ctrl`, selected by a MODE bit at 0x38.
    The buffers stay. They are how steps 12 and 13 ran, they are readable back, and
    a bring-up that cannot re-read what it loaded cannot interpret what it gets out
    -- so MODE 0 remains the slow path a failing fast path is diffed against.
    Everything below the mux is untouched: same core, same four read masters, same
    write master, same register map.
    `tb_at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
    [attn_ctrl.sv, tb_attn_ctrl.sv]
2026-09-05 Add the DMA block design and drive it from the A53
    The BD gains an axi_dma with 512-bit streams on both sides -- the core's own
    beat width, so nothing converts on the way in or out and the payload a host
    builds IS the beat stream the block consumes, which is what plan.MD asked the
    protocol to preserve.
    It gets HPC0, its own coherent port, not a share of an HP port. All four HP
    ports carry a KV read master and the design is sized against them delivering
    16.0 GB/s; putting 15 KB per token onto one would tax the exact resource the
    architecture is short of. HPC0 is otherwise idle, and being coherent it also
    removes a class of stale-data bug from the token buffers.
    The DMA's registers sit at 0x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
    [attn_main.c]
2026-09-05 Define the wire format, and make the two definitions check each other
    Step 14's protocol. A request's payload is EXACTLY the 512-bit beat stream
    `attn_top` consumes, in the order `hw/vectors.py` packs it, so the A53 hands
    received bytes to the DMA without touching them and the DMA hands them to the
    core without converting a width. Any repacking on the PS is a memcpy of the
    whole token on the critical path, and step 13 measured what that costs.
    The host owns the cache map: `cache_base`, `head_stride` and `plane_span` come
    down with every step and the board keeps no copy. `hw/ddr_layout.py` computes
    the layout and also built the image, so exactly one place knows it; a board
    holding its own wo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
2026-09-05 A mock board on x86, and the client that will talk to the real one
    plan.MD asks the wire format to be validated against a stand-in before
    board-side software exists. This is that stand-in, plus the client that will
    later point at the board instead.
    The mock ANSWERS FROM board_vectors' own table and does not recompute
    attention. That is a refusal, not a shortcut: answering properly would mean
    unpacking the wire q/k/v, rotating, quantising, appending to a cache and
    running the online scan -- the kernel's internals written a second time, in
    the one place in this project with no test of its own. A second golden model
    that agreed with the first would prove nothing and would drift the moment
    eith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
    [attn_client.py, attn_mock.py, test_proto.py]
2026-09-05 The DMA on hardware: 32 steps, four contexts, both paths, all bit-exact
    results/step14_dma_f250.log. Every case runs twice -- AXI-Lite buffers and DMA
    -- and both are checked against the goldens, so the fast path agreeing with the
    slow one is not what passes it. It is also the first hardware run of the
    normalised divide, so every golden in it is new.
    The transport is gone: 366 us becomes ~5 us and stops growing with context,
    because the transfer overlaps the scan instead of bracketing it. A step at ctx
    64 is 30 us against a 27 us block -- the shim has stopped being the
    measurement. 13.3x at ctx 64, 2.1x at ctx 8,192.
    ctx 8,192 ran for the first time: 1.17 cyc/row, 11.1 GB/s, 85% of what th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
2026-09-05 Probe the long-context address pattern without a golden
    Step 14 found per-group starve going 8.0, 8.8, 9.6 and then 154.5 cycles at ctx
    8,192 -- a fixed per-group round trip plus a per-row term that does not
    amortise. Whether that term keeps climbing is the question the 32k headline
    rests on.
    Answering it bit-exactly needs a 16.9 MB image in the ELF and an O(T^2) numpy
    prefill. Neither is needed to measure an ADDRESS PATTERN, so the A53 fills DDR
    itself and nothing is compared against a golden -- the answers are wrong by
    construction and are never looked at. The ELF does not grow and the bitstream
    is unchanged.
    The synthetic image does bias the result, and the bias runs the safe way. A new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
    [attn_main.c]
2026-09-05 Measure 32k: DDR keeps up, and the throughput table was 1.25x optimistic
    The probe answers the question step 14 raised. Per-row starve does NOT keep
    climbing: 0.0202, 0.0184, 0.0183 cyc/row at ctx 8k, 16k, 32k. It plateaus.
    Per-group starve tracks the row count linearly -- 165.7, 302.7, 601.1 -- so
    above ctx 8k the fixed round trip has vanished into the noise and starving is
    one steady-state rate, about one cycle in fifty-five. PARALLEL_KV = 1 at 4b/2b
    is fed at every context this design targets, measured at the far end instead of
    extrapolated to it.
    That is two guesses about this number in two days, wrong in opposite
    directions. Step 13 read three monotone points as a falling trend; step 1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
2026-09-05 Make the cost model predict the board, so step 15 can be assessed
    Step 15's exit criterion is "measured bytes, cycles and throughput move as
    config.py predicts". It did not. The model answered 58.8 B/cycle -- the smaller
    of the 14.7 GB/s DDR supply and the 64 B/cycle interface -- where the board
    sustains 45.6. It had no term for the fact that PARALLEL_KV = 1 retires ONE ROW
    PER CYCLE, so the engine's own demand ceiling is row_bytes per cycle: 13.0 GB/s
    at 52 B and 250 MHz. That missing term is 29%, and it is the same error that
    made plan.MD's throughput table 1.15-1.25x optimistic.
    CacheConfig gains `engine_bytes_per_cycle` and a `scan_cycles(groups, tokens)`
    fitted to six hardware contexts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
    [test_hardware.py]
2026-09-05 Feed the silicon a real model: Llama 3.2 1B on WikiText
    Every number the board has seen so far came from rng.standard_normal * 0.02.
    That was the right stimulus for proving a datapath -- reproducible from a seed,
    no structure to hide a bug behind -- and it is the wrong stimulus for one
    question.
    Real activations have a dynamic range pseudo-random ones do not. plan.MD's step
    4 gate measured exactly that: 8,188 tokens of WikiText-2 through all 16 layers,
    peak |x| = 24.957 against a +-128 rail, 19% above what 400 tokens suggested.
    Every hardware run since has been on Gaussian noise. So the board's clips,
    overflows, range_error and norm_saturated counters have reported zero for 32
    steps of stim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
2026-09-05 Real inference: the FPGA in the loop of a live model
    The board computes one layer's attention, per token, while the host runs the
    other fifteen layers -- and the board's numbers are USED, not checked against.
    kernel.py's seam is merged = merge_heads(out); acc = to_float(merged); y =
    project(W_o', acc), so the FPGA's 2,048 lanes go through to_float and W_o' and
    become the layer's output. The next token is produced from them. A wrong answer
    on the board changes the text.
    TRANSPORT IS A MAILBOX, NOT THE SHIM'S REGISTERS. Driving attn_ctrl directly
    over JTAG costs one transaction per 32-bit word -- 3,840 words a step, roughly
    a millisecond each, four seconds a token. So the slow link carries BU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
    [attn_jtag.py, attn_main.c, attn_server.h]
2026-09-05 Enable GEM3: the Ethernet the board side needs
    The ZCU104's RJ45 hangs off GEM3 on MIO 64..75 with MDIO on 76..77, and the
    board preset did not turn it on -- the generated device tree carried
    gem3: ethernet@ff0e0000 { status = "disabled" }, so there was no MIO routing
    and no psu_init for it. Nothing in the PL changes; this is PS peripheral
    configuration, baked into the platform, so it costs a full rebuild.
    Found by checking the platform's device tree BEFORE writing a GEM driver
    against a peripheral that was not wired up.
    Claude-Session: https://claude.ai/code/session_011VX58UrAq2gJAkNTMBgyyL
2026-09-05 The A53's raw Ethernet server: step 14's actual transport
    The board side that did not exist. GEM3, polled, no IP, no lwIP, no OS.
    WHY NOT A STACK. plan.MD budgets 35 us of round trip and 123 us of wire time
    for a 15 KB token at ctx 32k, against 927 us of DDR -- so the network is a
    minor term and the only thing that would make it a major one is a stack. lwIP
    on a baremetal A53 costs more in copies and timers than the wire costs in
    nanoseconds.
    The PHY address is SCANNED, not assumed: boards move the DP83867 between MDIO
    addresses and a wrong constant looks exactly like a dead link, which is the
    least diagnosable failure in the file. Link status is read TWICE because the
    bit latches low -- r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
    [attn_client.py, attn_eth.c, attn_eth.h, attn_main.c, attn_proto.h, test_proto.py]
2026-09-05 All sixteen layers on the board, and no prefill anywhere
    Two things were wrong with one-layer-with-a-pushed-cache as a demonstration.
    One layer of sixteen meant every throughput figure was one measurement times
    sixteen -- an extrapolation wearing a measurement's clothes. And a pushed cache
    meant the rows the block scanned were rows the HOST had computed in numpy; the
    hardware's write path was exercised for four tokens of a test case and nothing
    else.
    Now the block serves all sixteen layers and NOTHING is ever loaded. The prompt
    is fed one token at a time through the same decode path a generated token
    takes, so every row of every cache is written by the block's own AXI write
    master -- from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
    [fpga_layers.py]
2026-09-05 Make the Ethernet link diagnose itself
    A bare TimeoutError is consistent with at least six faults and distinguishes
    none of them: an older ELF on the board, a PHY that never came up, a MAC filter
    that drops us, a wrong ethertype, a down interface on this side, or a reply
    that is sent and lost. Reading a Python traceback tells you which of those it
    is exactly never.
    host/eth_probe.py listens PROMISCUOUSLY on every ethertype and reports what it
    saw rather than what it expected, answering three questions in order: can this
    side transmit, does ANYTHING arrive from the board's MAC, and does a reply
    arrive with our ethertype and parse. Each "no" has a different next action and
    the verdict names i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
    [attn_client.py, attn_eth.c, attn_eth.h, attn_main.c, eth_probe.py]
2026-09-05 One command to program the board and read its verdict
    The three-terminal dance has an ordering that is easy to get wrong and whose
    failure mode is an empty log or a client run against a board that was never
    reprogrammed -- which looks exactly like a dead link, and did.
    This starts the UART capture, programs the board, waits, prints the log, and
    classifies it: Ethernet up, Ethernet failed and fell back, an older
    JTAG-mailbox ELF, a self-test that passed with no server, or a silent UART.
    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
2026-09-05 Fix the receiver: the BD ring was a quarter of its required size
    The UART said it plainly once it was asked: PHY found at MDIO 12, link up at
    1000 Mb/s, server ready, and `rx 0 (0 ours)` -- the MAC accepting no frames at
    all, not merely rejecting ours. Three bugs, found by reading the driver's own
    example instead of guessing again.
    THE RING SPACE WAS FOUR TIMES TOO SMALL. A descriptor is 8 bytes but
    XEMACPS_BD_ALIGNMENT is 64, so XEmacPs_BdRingCreate spaces them 64 bytes apart.
    Sizing the array as `count * sizeof(XEmacPs_Bd) * 2` gave 1,024 bytes for a
    ring needing 4,096, and it ran off the end into the transmit ring and the frame
    buffers. BdRingCreate returned success the whole time. XEmac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
    [attn_eth.c]
2026-09-05 The GEM never saw its descriptors: the driver does no cache maintenance
    `xemacps_bdring.c` contains no Xil_DCache call of any kind. Every flush and
    invalidate is the caller's job, and this code did none. The A53 wrote
    descriptors into cached DDR, the GEM read DDR without coherency and saw what
    was there before the lines were written back -- zeros -- so it owned no receive
    buffers and accepted no frames. That is exactly `rx 0 (0 ours)` with the PHY up
    and the link negotiated at 1 Gb/s.
    The rings are flushed after setup and after every ToHw, and invalidated before
    every FromHw. They are 1,024 and 256 bytes, so whole-ring operations are a
    handful of cache lines and are done rather than trackin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
2026-09-05 One wrapper so the host tools cannot be run from the wrong directory
    python -m kernel.<x> from inside the repository imports kernel.py -- the module
    -- rather than kernel/ -- the package -- because the working directory shadows
    it, and the ImportError about relative imports names nothing that is actually
    wrong. The directory, the interpreter and the sudo are chosen by the script
    instead of by whoever is typing.
    --cpu-only and --jtag drop the sudo: they touch no raw socket, and running them
    as root leaves root-owned files in the workspace.
    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
2026-09-05 The client was reading its own transmissions
    An AF_PACKET socket sees the frames it sends. `eth_probe` proved it and I did
    not carry the lesson across: it reports "0x88b5 x10" for five pings, and it
    filters by source MAC, which is why it worked. `RawEthClient` did not filter,
    so its receive loop could reassemble the REQUEST it had just sent as though it
    were the reply.
    That failure is not obviously a failure. A request parsed as a response has a
    matching magic, and the `version` field lands exactly where `status` is read --
    so it decodes as a valid response with status 1, not as garbage.
    Two guards, not one. PACKET_IGNORE_OUTGOING is asked for and is the clean fix
    on a 4.20+ kernel; the so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
    [attn_client.py, fpga_layers.py]
2026-09-05 Print the request the board actually decoded
    Status OK with a zero payload is only reachable through the CMD_PING branch, so
    the board parsed a step request's cmd as 0 while the client provably packs 1 --
    verified directly: cmd 1, payload 9216, 7 fragments, last chunk 300 B.
    Two theories about this path have each cost a rebuild. What the board decoded is
    cheaper than a third: seq, fragments seen against expected, reassembled length,
    and every header field as parsed.
    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
2026-09-05 A whole-ring flush erases what the GEM just wrote
    The log was precise and misleading: the first request assembled perfectly --
    7/7 fragments, every header field correct, the step ran and replied in 22 us,
    and layer 0 completed -- and then reception stopped dead.
    The GEM writes status bits into descriptors as frames land. bd_flush_rx()
    flushed all 64, writing this side's stale cached copies back over those
    updates. The frames were received and then un-received. Requests 2 onward were
    never assembled, which surfaced on the host as a bare timeout with 0 of ?
    fragments.
    A flush now covers exactly the one descriptor this side modified. Whole-ring
    invalidate stays -- it discards clean lines and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
    [attn_eth.c]
2026-09-05 Clear RXBUF_NEW on re-arm: the frame was delivered 948,353 times
    The board's own counter named it: 948,353 steps served for a run that asked for
    about a hundred, replying roughly 30,000 times a second and saturating the link
    at 300 Mb/s. From the host that looked like a hang eight layers in.
    Bit 0 of an RX descriptor's address word means the GEM has filled that buffer,
    and the CPU clears it to hand ownership back. XEmacPs_BdSetAddressRx
    deliberately PRESERVES the low bits -- it masks the address in -- and
    XEmacPs_BdRingToHw never touches them: RXBUF_NEW_MASK does not appear in any
    of the driver's .c files, only as macros in xemacps_bd.h for the caller to use.
    Left set, the GEM will not reu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
2026-09-05 Reproduce the live-inference failure in the self-test, and stop the wedge
    Token 1 is bit-exact on all sixteen layers and every token after it diverges.
    That is a regime nothing in this project has executed: tb_attn runs T = 65, the
    preloaded cases T >= 1021, the probe T >= 8193. A decode run STARTS at T = 1
    and every row it scans was written by the block a step earlier -- the preloaded
    cases only ever wrote the last handful of rows onto the end of a host-built
    image.
    So ('fresh', 0, 6) runs in the self-test: nothing preloaded, six steps, T = 1
    through 6, every row the block's own. If that fails on the board the fault is
    in the block at small T and has nothing to do with Ethernet or the mode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
    [attn_main.c]
2026-09-05 Zero the cache regions before inference
    Both transports produce byte-identical wrong answers -- JTAG and Ethernet agree
    to the channel on every token -- so the wire is not the fault. And token 1
    always agrees, which is a clue rather than a coincidence: at T = 1 the softmax
    is over one element, p/l = 1, and the output is the decoded VALUE alone. The
    stored KEY is mathematically irrelevant there. A wrong key row is invisible at
    T = 1 and appears at T = 2, which is exactly the pattern.
    So the board's cache rows differ from the host's, and the one concrete
    difference between the self-test's case -- which passes at T = 1..6
    with identical geometry and every row hardware-written -- and live infe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
    [fpga_layers.py]
2026-09-05 One command that brings the board up, runs, and shows what it said
    Three things kept going wrong by hand and none of them were interesting: the
    package-shadowing import error, a wedged board from a previous run failing at
    the ping and looking like a new fault, and the UART -- where the board explains
    itself -- only being captured when someone remembered a second terminal.
    The wrapper now pings first, reprograms if there is no answer, always captures
    the UART, and prints the board's own lines at the end. on its own
    reprograms and stops.
    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
2026-09-05 A CMD_LOAD larger than one token is never answered
    The board reassembles into a buffer sized for a token -- 64 + 9,216 bytes --
    and drops any fragment that would run past it. Zeroing a 131,072-byte cache
    region asked it to swallow 88 fragments into a 9,280-byte buffer: fragments
    past the seventh were discarded, the message never completed, no reply was
    ever sent, and the host reported 'no reply after 0 of ? fragments' -- which
    names nothing about the actual limit.
    The host splits into 8,192-byte pieces with an advancing base. The limit is now
    written down in both halves of the protocol next to the token size, so the next
    caller to exceed it does not have to rediscover it from a timeout.
    It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
2026-09-05 One descriptor per cache line: the flush was erasing its neighbours
    The board's own log finished the diagnosis: sixteen CMD_LOADs served without
    trouble, one STEP served, then reception dead. A load's reply is one frame; a
    step's reply is five.
    `rings 1024 B for 64 descriptors` means 16 bytes per descriptor, and a cache
    line is 64 -- so four descriptors share a line. Cache maintenance has no finer
    granularity than a line, so flushing the ONE descriptor this side modified also
    wrote back stale copies of its three neighbours, erasing whatever the GEM had
    written into them meanwhile.
    That is the single fault behind every receive failure in this file. The
    whole-ring flush destroyed all sixty-f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
    [attn_eth.c]
2026-09-05 Read the board's cache rows and diff them against the host's
    Live inference agrees on token 1 and differs on every token after, identically
    over JTAG and Ethernet, with the region zeroed. Deterministic, and not the
    transport.
    Token 1 is the clue rather than a coincidence: at T = 1 the softmax is over one
    element, p/l = 1, and the output is the decoded VALUE alone -- the stored KEY
    cannot affect it. A wrong key row is invisible at T = 1 and appears the instant
    a second row exists.
    That is a claim about bytes in DDR, so this reads them: step the board over
    JTAG, pull the cache region back, reassemble with DdrLayout.row_at -- the same
    function that built every image this project has loaded --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
2026-09-05 The ring array was a quarter of the ring, and sudo hid xsdb
    Two bugs, both caught by lines added earlier for exactly this purpose.
    XEmacPs_BdRingMemCalc sizes for the descriptors alone and not for the
    separation the alignment forces: at BD_SEP = 64 it answered 1,024 bytes for 64
    descriptors that occupy 4,096, so the ring ran off the end of the array into
    the transmit ring and the frame buffers. The bring-up line reading '1024 B for
    64 descriptors at 64 B each' is three numbers that cannot all be true, which is
    the only reason this was visible at all. Sized explicitly now.
    Ironically this is the bug I wrongly claimed two rounds ago and then actually
    created by changing the alignment without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
    [attn_eth.c]
2026-09-05 The host was using 3-bit keys against a 4-bit-key bitstream
    Root cause, found by reading the board's cache bytes instead of theorising
    about them for a fifth time.
    `QuantConfig()` defaults to key_bits=3, and `graft()` takes that default unless
    told otherwise. `attn_top` is synthesised with KEY_BITS=4. So the host computed
    3-bit key codes -- a 44-byte row -- for hardware that decodes 4-bit ones and
    writes a 52-byte row, and the stored keys could never agree.
    It hid almost perfectly. At T = 1 the softmax runs over a single element, so
    the output is the decoded VALUE alone and the stored key cannot affect it:
    token 1 matched every single time. Values and norms matched throughout, because
    both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
2026-09-06 Llama 3.2 1B runs with all sixteen layers' attention on the FPGA
    208 decode steps, 208 exact, 0 different. Every layer, one token at a time, no
    prefill anywhere, every row of every cache written by the block's own AXI write
    master -- the first token scanned one row it had just written and the last
    scanned thirteen, all its own.
    The history of computing hardware spans centuries, from mechanical calculators to
    The board's numbers are what the model consumed: to_float, W_o', residual. Those
    words were produced from them.
    358 us a token across sixteen layers, 22 us a step, which is 2,796 tok/s if the
    transport were free. It is not: this ran over the JTAG mailbox at 999 ms a step,
    so 0.0% of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
2026-09-06 Harden the Ethernet server, and log every step so it names its own failure
    The board brings the link up, serves the ping, sixteen loads and about four
    steps, and then stops replying -- while still RECEIVING and parsing the
    requests, which the seq 259 and 260 lines show. So it reassembles a step and
    does not answer it.
    Four changes, none of them a theory about which of those it is:
    * The transmit ring goes from 16 descriptors to 64. A reply is five frames
    and a leak of one descriptor per failure kills the transmitter after
    sixteen.
    * Every exit from attn_eth_send frees or un-allocates its descriptor.
    Returning without doing so was a silent leak on two paths.
    * The transmit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
    [attn_eth.c, attn_main.c]
2026-09-06 Clear the latched receive status, or the GEM stops for good
    The counters made this one findable. rx advanced by exactly 7 per step and tx
    by exactly 5, device time 22 us every time, for 256 cache-zeroing loads and
    nine decode steps -- 1,600 frames of perfectly regular behaviour -- and then
    reception stopped dead. Nothing degraded; it simply ceased.
    XEMACPS_RXSR_BUFFNA_MASK latches the instant the controller finds no free
    descriptor, even momentarily, and while it is set the receiver stays off no
    matter how many descriptors are handed back afterwards. It is
    write-one-to-clear, and the only code in the driver that clears it is in
    xemacps_intr.c -- the interrupt handler. This server is polled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
2026-09-06 NORESET=1: ask a wedged board a question instead of reprogramming it
    The auto-bringup is right for a normal run and wrong for a post-mortem: it
    destroys the state that would say what happened. NORESET=1 leaves the board as
    it is.
    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
2026-09-06 Record what is known about the Ethernet failure, and stop guessing at it
    The probe after a failure is decisive: the board answers nothing, not even a
    ping. It serves 256 cache-zeroing loads flawlessly -- 1,540 frames, +6 per load
    exactly -- and then dies after 1, 4 or 9 decode steps depending on the run.
    The step it dies after completes correctly and sends all five reply fragments;
    the next request is never reassembled; RXSR error bits are never set, so
    BUFFNA, overrun and HRESPNOK are all excluded by the hardware itself.
    Single-frame replies never trigger it and five-frame replies do. And the count
    VARIES between runs, which rules out a deterministic logic error and points at
    a race or at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
2026-09-06 Jumbo frames: a reply is one frame instead of five
    The easy way, and the evidence supports it. Five-frame replies are what kills
    this receiver; 256 consecutive single-frame replies never did. At an MTU of
    9,000 a 6,188-byte reply travels in ONE frame and a 9,252-byte request in two,
    so the pattern that fails stops occurring rather than being understood.
    The GEM takes XEMACPS_JUMBO_ENABLE_OPTION and supports 10,240-byte buffers. The
    option is set before the rings are built, because it changes the receive buffer
    size the driver programs into DMACR.
    Both ends must agree on the fragment payload or fragments land at different
    offsets and reassemble into a token of the right length and the wrong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
    [attn_client.py, attn_eth.c, attn_proto.h, attn_proto.py, test_proto.py]
2026-09-06 Size the frame buffer for jumbo: it was still 1,600 bytes
    Jumbo worked at the frame level immediately -- requests became two fragments and
    replies one, which is what it was for -- and then both directions truncated: a
    request arrived with 36 of 8,228 payload bytes, a reply with 1,986 of 6,144.
    `eth_frame` was 1,600 bytes, sized for a 1,500-byte MTU, and a fragment is now
    up to 9,000. Every jumbo frame overran it, in both directions: reassembling a
    request into it and building a reply out of it.
    Sized from ATTN_MTU_PAYLOAD now, so it cannot drift from the MTU again. That is
    the same class of mistake as the ring array being a quarter of the ring --
    changing a size constant without following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
    [attn_main.c]
2026-09-06 Use lwIP for Ethernet instead of a hand-rolled GEM driver
    Five real bugs in a polled driver of my own -- descriptor cache maintenance the
    driver does none of, RXBUF_NEW never cleared on re-arm, four descriptors to a
    cache line so a flush erased its neighbours, a ring array a quarter of the size
    its alignment demanded, a frame buffer left at the old MTU -- and a sixth never
    found: the receiver stops after one, four or nine steps depending on the run,
    with no error status set. A varying failure point is a race, and hand-racing a
    DMA engine from a poll loop was the wrong thing to be doing.
    Xilinx maintains an lwIP port for this exact controller (xemacpsif_dma.c,
    xemacpsif_physpeed.c). It owns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
    [attn_client.py, attn_main.c, attn_net.c, attn_net.h, attn_proto.h]
2026-09-06 Put the host MTU back to 1500 for lwIP
    The jumbo experiment left enp4s0 at 9000. lwIP's netif is a standard 1500-byte
    MTU, so the host was emitting single 8 KB frames the board could not accept:
    the 36-byte ping worked and every 8 KB load vanished. At 1500 the host's IP
    stack fragments and lwIP reassembles, which is the entire reason for moving to
    UDP.
    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
2026-09-06 Fix the reciprocal width, and gate the numpy check behind verify
    Two unrelated things that happen to live in the same files.
    The bug: rtl/finalize.sv sized its divider as RECIP_BITS = RECIP_FRAC +
    PROB_FRAC + 1, while ops/attention.py used a standalone RECIP_NORM_BITS = 32.
    Those agree today, at 16 + 15 + 1, by coincidence. Normalising the divide
    stopped the arithmetic depending on either field and nothing went back to
    change how the RTL derived its width, so a change to prob_frac would have
    resized the hardware's divider and left the model's alone.
    Bit-exactness could not have caught it, because the goldens come from the
    model -- the board would have been wrong and agreed with itself. Thi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
    [finalize.sv, fpga_layers.py, tb_kv_store.sv]
2026-09-06 Rewrite comments and documentation in plain language
    The prose across the package had drifted into a style that shouts: ALL-CAPS
    section headers, capitalised words for emphasis, and in plan.MD a bold span
    every five lines, which means nothing stands out. This rewrites it as ordinary
    engineering prose. 122 section headers to sentence case, about 465 emphasis
    words lowered, and every module docstring in the numeric core rewritten by
    hand.
    None of the 66 source files in this commit changed any code. That is checked
    rather than asserted: for Python by comparing ASTs with docstrings stripped,
    for SystemVerilog and C by comparing the source with comments removed. Line
    counts are unchanged in all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
    [accum.sv, attn_client.py, attn_ctrl.sv, attn_eth.c, attn_ingress.sv, attn_jtag.py]
2026-09-06 Verify live activations bit-exact to ctx 1,024
    ./scripts/attn ppl --tokens 1024 with the per-step check on: 16,384 of 16,384
    decode steps exact, zero clips, zero overflows, no channel outside the 24-bit
    seam.
    This replaces the previous live figure of 4,096 steps to ctx 256. The gap that
    remains is ctx 1,025-4,096 on live activations, and it is bracketed either side
    by synthetic vectors that are checked (ctx 64/256/1,024/8,192, step 14).
    The scan lands at 1.301 cyc/row over 67,174,400 rows, which is where the series
    predicts a mean context of 512: 1.30, 1.28, 1.17, 1.14 at mean contexts of 512,
    2,048, 8,192 and 32,768. Starving 2.31%.
    Perplexity at 1,024 tokens is 5.981 -> 7.256, ratio 1.2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
2026-09-11 Switch the kv-asymmetry plot/section to 1/perplexity (higher = better)
    Replaces the perplexity-vs-(key_bits+value_bits) plot and its plan.MD
    table with the 1/ppl version -- same finding, same data, axis flipped
    so higher reads as better. Adds the --invert flag to
    plot_kv_asymmetry.py that produces it.
    Claude-Session: https://claude.ai/code/session_01CUMLo2WMXQJBifK4VhK8Zm
2026-09-11 Switch both plots to monochrome
    Pareto plot: open black circles instead of tab:blue. KV-asymmetry
    plot: black marker shape distinguishes the relation (filled circle
    k>v, gray square k=v, open triangle k<v) instead of hue.
    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
2026-09-13 Add a batched causal path for architecture A (dense score mode)
    attend_two_pass, called once per query token from the prefill loop,
    re-decoded and un-rotated the entire causal prefix from scratch at every
    step -- O(n^2 d) work for a window of n tokens, since nothing about the
    decode depends on the query. attend_causal_batch_dense decodes the cache
    once per window and reuses it across query tiles, with the same per-term
    truncation order as the token loop so the result is bit-identical, not
    merely close (pinned by check_causal_batch_dense_is_bit_identical). Wired
    into kernel.py's dispatch and the force_token_loop fallback removed from
    both experiment drivers, since neither architecture needs t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
2026-09-14 Add a process-level parallel launcher for the config grid
    Profiling wikitext_ppl.py's hot path (cProfile on attend_causal_batch at
    Llama's shape) showed the actual bottleneck is not ops/quantize.py's
    encode step (2% of time) but plain NumPy ufuncs inside
    ops/attention.py -- ExpLut's table gather and fixed-point bookkeeping
    (floor, astype, rshift, causal masking), which don't auto-parallelise the
    way the file's matmuls already do (confirmed OpenBLAS is multi-threading
    those: a same-shape matmul got a real 6x speedup from threading, forced
    single-threaded vs default).
    Given the choice between thread-parallelising that code (real speedup,
    but needs auditing CompressedAttention's mutable per-ca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
2026-09-20 Add a symbolic hardware architecture figure for the paper
    Labels the datapath with parameter symbols rather than the evaluated
    widths, so a bit-width sweep does not invalidate the figure. The three
    derived relations are printed as formulas -- R = d(b_k+b_v)+2w_n,
    P = ceil(R/(w_axi/8)), compression = 2*d*16/R -- and the concrete
    configuration appears in exactly one line at the bottom.
    The DDR band states the transposed plane layout from kv_store_ddr.sv:
    plane p holds row bytes [sum W_i, +W_p) for every token, which is the
    reason P ports are needed at all and is not visible from the row format.
    Draft for review; the port to TikZ comes after the layout settles.
2026-09-20 Move the power-of-two head-dim constraint off the rotation block
    "Walsh-Hadamard" already implies a power-of-two size to this audience, so
    the adjacent "d = 2^m" was redundant -- and it was the figure's only
    constraint annotation, which gave a minor architectural limit more weight
    than a diagram explaining the mechanism should.
    The constraint still appears once, in the parameter box where d is
    defined, stated as the domain of a parameter rather than as a caveat
    hanging off a datapath block.
    Claude-Session: https://claude.ai/code/session_01CvZvpeUQRt1BsQCKyca7at
2026-09-20 Redesign the hardware figure: nest the blocks, draw the row to scale
    The flat box-chain spent its width on equal-weight boxes and pushed the
    result into a three-line parameter block underneath, which is a table
    wearing a figure's clothes. Two changes, both borrowed from figures that
    work:
    Containment carries the hierarchy, so host, block and DDR need almost no
    arrows between them, and the lane array is drawn as a visible stack
    rather than one box labelled "x G".
    Panel (b) draws the fp16 row and the codes row to scale, so 4.92x is
    something the reader measures off the page instead of something the
    caption asserts. Magnifying the codes row underneath it puts the field
    boundaries above and th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
2026-09-20 Turn the figure around so egress returns to the host
    The output arrow used to leave finalize and climb toward the top of the
    frame, where DDR sat -- so the one arrow carrying the block's result
    pointed at the cache. Moving DDR to the right wall and the host to the
    left one fixes it structurally rather than cosmetically: the write path
    runs left to right along the top into DDR, the read path runs right to
    left along the bottom and lands in the host, and the figure is a loop.
    kv_store_ddr now sits outside the x G container instead of inside it,
    which is what the RTL actually says -- one read engine, P masters, one
    row a cycle, all G lanes reading it together. Sharing is a thing the
    picture sh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
2026-09-20 Add a coloured variant of the hardware figure for comparison
    One accent hue, carrying one meaning: the path a compressed row takes.
    The tint starts at rot_encode, where the data first becomes codes, and
    follows it through kv_write, DDR, kv_store_ddr and into score_lane,
    which is the claim the paper makes -- a cached key is written, stored,
    streamed back and scored without ever being decompressed. Everything
    upstream of the encoder stays white, so the break in colour is the point
    at which compression begins.
    Blue rather than a red/green pair, so it survives colour blindness, and
    the tints sit far enough apart in lightness to still separate when the
    proceedings print in greyscale.
    Kept as a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
2026-09-20 Make the greyscale shading mean the same thing the colour does
    The grey fills always marked the compressed-row path, but nothing in the
    figure said so and the set was never reconciled with the coloured
    variant: rot_norm was shaded here and not there, kv_store_ddr was shaded
    there and not here. Unexplained and inconsistent shading reads as
    decoration, which is worse than none.
    Both versions now shade exactly the same blocks -- rot_encode, kv_write,
    DDR, kv_store_ddr and score_lane -- give the same four arrows the same
    extra weight, and carry the same one-line key with a swatch. rot_norm is
    white in both, because the data is not codes until the encoder.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
2026-09-20 Close the lane container without slashing across it
    The border was drawn as one path with gaps in it, and ended in Z. Z
    closes back to the start of the current subpath, not the start of the
    path, so it ran a line from the bottom-left corner up to the top of the
    break in the right edge -- straight across the lanes. The left edge was
    never drawn at all; the diagonal was standing in for it.
    The closing segment is now explicit, and the check that runs with the
    XML validation rejects any multi-subpath path ending in Z and any
    segment that is neither horizontal nor vertical.
    Claude-Session: https://claude.ai/code/session_01CvZvpeUQRt1BsQCKyca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
2026-09-20 Add a first draft of the inference-flow figure
    Two bands. The top one is a token's pass through the model, with the
    next token re-entering at the front rather than branching off, because
    that loop is the claim: prompt tokens take the decode path too and no
    prefill stage exists anywhere. The lower band expands a single layer
    into the only place the two sides meet, so the seam is crossed twice per
    layer and L times per token.
    Styled to match the hardware figure -- same fonts, greys, arrow marker
    and host tint -- so the pair reads as one system, and the block itself
    is a reference to Fig. 1 rather than a second drawing of it.
    Claude-Sessio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
2026-09-20 Drop the inference-flow figure
    Fig. 1 already carries the architecture: it shows the host, the block
    and the cache, what crosses between them, and the order the heads run
    in. A second figure whose top band is the transformer every reader
    already knows adds a page of space and one fact -- that there is no
    prefill -- which the text can state in a sentence.
    Kept in history in case a longer version of the paper wants it.
    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
2026-10-03 Re-render both plots from the 12-window grid
    The committed PNGs were still the single-run data. Both are regenerated
    from the new means, the asymmetry one with --invert, which is the form
    its own commit established.
    Two readability fixes found by looking at the output rather than at the
    code. The pareto plot gets a log y-axis: k2v2 is 103 against 9.4 for
    everything from k4v3 on, so on a linear axis the one configuration
    nobody would ship flattened the eight being chosen between into a band
    two pixels tall, and the knee at k4v2 -- the whole point of the figure
    -- was invisible. Its title also ran off the right edge after the
    earlier wording fix, so it now sets on two lines.
    The asymmetry pl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
2026-10-03 Give all three figures one colour vocabulary
    experiments/palette.py holds the hues and what they mean, so the three
    figures agree rather than each inventing its own. Okabe-Ito, no
    red/green pair carrying meaning, and the two primaries far enough apart
    in lightness to survive a greyscale printing.
    blue what this design does, and what wins
    orange the alternative being argued against
    grey neutral, or out of reach
    vermilion used once, for the configuration that shipped
    The footprint plot gains the constraint it was missing: points are split
    by whether the configuration fits the ZCU104's four AXI-HP ports, so the
    grey half of the curve is quality this board cannot reach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
2026-10-03 Tint by region, and stop singling out one configuration
    The architecture figure was one accent on one path with everything else
    grey, which read as arbitrary rather than as a scheme. It now works the
    way the reference figures do: every region carries a tint and the blocks
    inside stay white, so where a block sits is what it is -- purple for the
    host, green for the programmable logic, a deeper green for the lane
    array nested in it, blue for the cache. Arrows take the two directions
    of the loop, vermilion for a token on its way into the cache and blue
    for the scan on its way back out, with a key for both.
    The footprint plot no longer marks 4b/2b, and the AXI-HP band is gone
    too: singling out o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
2026-10-03 Stage the architecture section beside the figure it includes
    ISFPGA_Submission is a separate repository synced to Overleaf and
    gitignored here, so the section cannot be committed to its destination
    from this tree. It is staged next to fig_hardware.tex instead, which
    keeps the prose and the figure it references in step and makes it one
    copy rather than a transcription when they move.
    The header lists the preamble it needs and every symbol it introduces,
    and records that the wording has not had a persona pass -- persona.md
    lives in the other repository and is not reachable from here.
    Claude-Session: https://claude.ai/code/session_01CvZvpe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
2026-10-03 Track the compiled proof alongside its source
    The PDF fig_check.tex produces is now in the tree rather than ignored.
    It is the only artifact in the repository that shows what the LaTeX
    actually renders to, and the faults compiling exposed -- overflowing
    columns, a sentence past the right edge, the TeX silently behind the SVG
    -- were all invisible in the source. Someone without a toolchain can now
    see the result.
    Named for its source so a rebuild updates the tracked file rather than
    leaving a second copy to drift.
    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
2026-10-03 State why 4b/2b was chosen rather than leave it implied
    The configuration is 18.3% above baseline, which a reader will question,
    and the honest answer is not that it is the best point but that it is
    the widest row four AXI-HP ports admit. The new subsection says that,
    and says what the constraint costs.
    The argument that carries it is the one a bytes axis cannot show. 3b/3b
    is the same 52-byte row and needs five ports, because a 24-byte field
    leaves an 8-byte remainder no other field can share, while 4b/2b lands
    on 32 and 16 bytes, two beats and one, with nothing wasted. Equal
    storage, different port cost.
    Nearly two thirds of the remaining accuracy gap sits one port past what
    the device h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
